Hemish-Patel/Sunrise-Alarm-Clock/CircuitBlueprint/PCB_Render.png

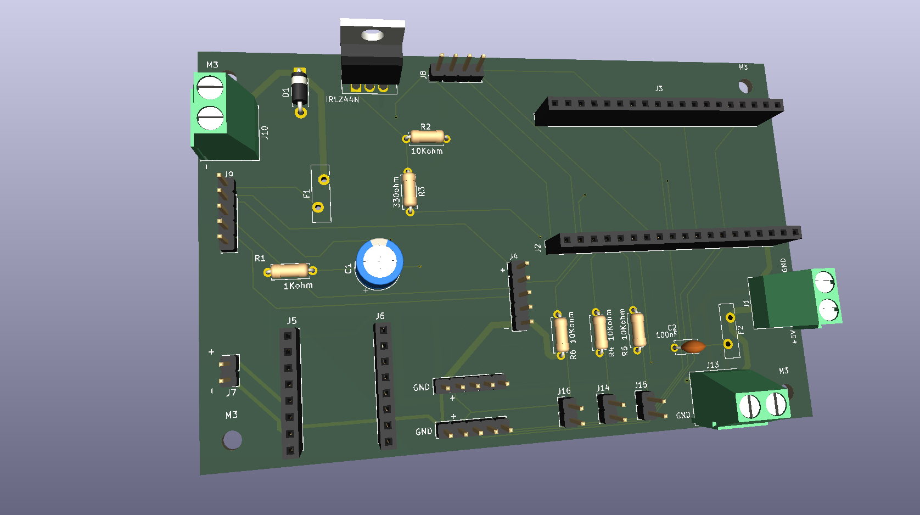
CircuitBlueprint/PCB_Render.png
