Hemish-Patel/Sunrise-Alarm-Clock/Docs/2_InitialDesign/INFO.txt

Sets out the hardware architectural decision, and initial circuitry
The components and parts that are needed to meet the system's requirements 
and how they fit together
