Hemish-Patel/Sunrise-Alarm-Clock/Docs/3_Schematics/INFO.txt

Sets out top level view of software flow
Main features, settings, and research on how to best implement the projects desired goals
