Hemish-Patel/Sunrise-Alarm-Clock/Docs/1_SystemRequirementsAndConstraints/1_SystemRequirementAndConstraints.docx

1. System Requirements & Constraints

1.1 Functional Requirements (FR)

What the system must physically do.

- FR-01 (Automated Lighting): The system SHALL execute a 45 minute dimming sequence, culminating at 100% brightness at a user-defined alarm time.
- FR-02 (Manual Override): The system SHALL provide an independent manual lighting mode, controlled via a dedicated physical rotary encoder, which overrides automated lighting schedules.
- FR-03 (Audio Output): The system SHALL output digitized audible alarms from local SD storage via a dedicated 3W speaker, triggered at specific points in build up to alarm time.
- FR-04 (Mechanical Output): The system SHALL actuate a physical twin-bell mechanical hammer mechanism at alarm time.
- FR-05 (Time Retention): The system SHALL maintain accurate real-time clock data during a total mains power loss, completely independent of network connectivity.
- FR-06 (Visual Output): The system SHALL provide continuous visual feedback of the current real-time clock data and system states (e.g., alarm armed/disarmed).

1.2 Non-Functional Requirements (NFR)

The quality standard to which the system must perform.

- NFR-01 (Acoustic Performance): The AC dimming circuit SHALL operate without inducing acoustic resonance (buzzing) in the LED load across the entire dimming range.
- NFR-02 (UX Handoff): The system software SHALL execute a "bumpless transfer" between automated alarm states and manual lighting states, preventing sudden voltage spikes or brightness jumps.
- NFR-03 (Tactile Operation): The primary alarm termination protocol SHALL be executable via a single, absolute-state hardware switch, requiring no navigation of the state machine.
- NFR-04 (Independent Alarm Features): The separate alarm features SHALL be independently activated and deactivated via absolute-state hardware switch, requiring no navigation of the state machine.
- NFR-05 (Domestic Aesthetic & Ambient Quality): The light emitter SHALL be aesthetically pleasing and deliver warm-spectrum, ensuring visual suitability as a decorative bedside light.

1.3 Design Constraints (C)

The absolute limits the design cannot cross.

- C-01 (Electrical Safety): The system MUST operate from a standard 230V 50Hz UK mains supply, enforcing strict protective electrical separation and hazardous-voltage isolation between the mains domain and all user-accessible low-voltage interfaces in compliance with relevant electrical safety standards.
- C-02 (Thermal Management): The system MUST maintain safe internal operating temperatures for the enclosure exclusively through passive ventilation, prohibiting the use of active cooling fans or high-thermal-loss resistive loads.
- C-03 (Budget): The total prototype Bill of Materials (BOM) MUST NOT exceed £100.00.
