Hemish-Patel/Sunrise-Alarm-Clock/Docs/2_InitialDesign/LogicalArchitecture.docx

| Option 1 | Option 2 | Option 3
Light Bulb Type | Cheap LED | Premium LED | Halogen
Dimmer Circuitry | Leading Edge TRIAC | Trailing Edge MOSFET

1. Lighting Architecture

1.1 Combinations:

- Combination A: Trailing Edge MOSFET + Cheap LED
  - Pros: Cool to the touch (great for 3D-printed enclosures), highly energy-efficient, zero buzzing because trailing-edge dimming is smooth for electronics.
  - Cons: Requires a complex/expensive module or a custom high-voltage MOSFET gate driver design.
  - Cost: High (~£24+ for dimming hardware).
- Combination B: Leading-Edge TRIAC + Halogen Bulb
  - Pros: Flawless dimming down to 1% (no "pop-on" dead zone), natural warm orange colour shifting, incredibly cheap hardware (£4 TRIAC module + £2 bulb).
  - Cons: Generates massive thermal heat (high risk of warping plastic enclosures), high energy draw (~42W–60W).
  - Cost: Low (~£6 total).
- Combination C: Leading-Edge TRIAC + Premium LED
  - Pros: Cool to the touch and energy-efficient (like an LED), uses the cheap £4 TRIAC module, and the premium bulb's internal active filtering absorbs the TRIAC spikes to eliminate buzzing while mimicking the halogen colour-shift.
  - Cons: Premium bulbs cost slightly more than generic ones (~£7–£9 per bulb).
  - Cost: Moderate (~£12 total).
- Combination D: Leading-Edge TRIAC + Cheap LED
  - Pros: Extremely low component cost, highly energy-efficient source lighting.
  - Cons: Severe acoustic resonance (loud electrical buzzing), poor dimming fidelity characterized by a wide "pop-on" dead zone and sudden drop-offs, and high risk of premature internal driver degradation due to unregulated phase-cut chopping spikes.
  - Cost: Very Low (~£7 total).

1.2 Evaluation:

( 5 Max (Good), 1 Min(Bad) )

Evaluation Criteria | Weight | Combination A (MOSFET + Cheap LED) | Combination B (TRIAC + Halogen) | Combination C (TRIAC + Premium LED) | Combination D (TRIAC + Cheap LED)
Acoustic Silence | 5 | 5 | 5 | 4 | 1
Thermal Safety | 5 | 5 | 1 | 5 | 5
Dimming Fidelity | 4 | 3 | 5 | 4 | 1
Energy Efficiency | 3 | 5 | 1 | 5 | 5
Implementation Cost | 3 | 2 | 5 | 4 | 5
Weighted Total Score | | 72 / 100 | 53 / 100 | 86 / 100 | 57 / 100

* Architectures combining a Trailing-Edge MOSFET with either a Halogen or Premium LED were excluded from the formal evaluation matrix. The higher-cost MOSFET topology is specifically implemented to mitigate the acoustic and dimming limitations of Standard LEDs. Pairing a MOSFET with emitters that already possess optimal dimming characteristics (Halogen) or internal active filtering (Premium LED) introduces redundant implementation costs with zero performance gain, immediately violating constraint C-03 (Budget).

1.3 Decision:

Winner: Combination C: Leading-Edge TRIAC + Premium LED

2. User Interface (UI) Architecture

2.1 Lighting & Menu Control (Rotary Encoder vs. Potentiometer)

To satisfy the manual lighting override (FR-02) and the "bumpless transfer" (NFR-02) requirements, an infinite-spin Rotary Encoder was selected over a traditional Analog Potentiometer.

- The State Desynchronization Flaw:
  - A potentiometer is an absolute input device. If the automated sunrise sequence brings the lamp to 100% brightness, but the physical potentiometer dial was left pointing at 10% from the previous night, touching the dial would instantly drop the brightness to 10%. This violent state mismatch violates NFR-02.
- The Encoder Solution:
  - A rotary encoder is a relative input device. It tracks positional changes (+1 or -1) rather than absolute position. This allows the ESP32 software to seamlessly sync the physical dial's input with the current software-driven brightness value, enabling a flawless, glitch-free handoff between automated and manual states.

2.2 Independent Alarm Feature Control (Toggle Switches vs. Push Buttons)

To satisfy the tactile operation requirement (NFR-03) and the independent alarm features requirement (NFR-04), three dedicated Hardware SPST Toggle Switches were selected as the arm/disarm interfaces for the light sunrise sequence, speaker noises, and metal bells, rather than utilizing the UI screen and push buttons.

- Modular Independence:
  - Providing dedicated hardware switches for the light sunrise sequence, speaker noises, and metal bells allows the user to physically customize their wake-up protocol (e.g., arming the sunrise light but disarming the mechanical bells) without needing to configure complex software settings.
- Bypassing the State Machine:
  - Utilizing physical toggle switches allows the user to immediately arrest specific lighting, digital audio, or mechanical alarm outputs via muscle memory without needing visual confirmation or UI navigation.
- Absolute State Confirmation:
  - The physical UP/DOWN position of each switch provides immediate tactile confirmation of exactly which individual alarm features are armed for the next morning, eliminating the anxiety associated with hidden software-only toggle states.

2.3 Visual Output (Integrated-Driver 7-Segment LED vs. Backlit LCD)

To satisfy the visual output requirement (FR-06), four display architectures were evaluated:

- Option A: Raw Multiplexed 7-Segment LED: Rejected.
  - Requires continuously multiplexing up to 12 GPIO pins, resulting in extremely poor pin economy that would consume an unacceptable percentage of the microcontroller's I/O budget.
- Option B: Backlit LCD Screen: Rejected.
  - Requires a continuous backlight that illuminates the entire rectangular footprint of the display, causing unwanted ambient light pollution in a dark room.
- Option C: OLED Module: Rejected.
  - While visually impressive, an OLED is functional overkill for displaying basic numerical digits and significantly increases component cost. Furthermore, organic pixels suffer from permanent burn-in when displaying static time data 24/7.
- Option D: Integrated-Driver 4-Digit 7-Segment LED (Selected):
  - Handles multiplexing locally via an integrated IC, offering excellent pin economy (requiring only a 2-wire serial interface). It emits light strictly from the active numerals and allows for software-defined brightness stepping, enabling a cost-effective, sleep-friendly nighttime mode.

3. Audio & Mechanical Alarm Architecture

3.1 Digital Audio Generation (Hardware Decoder vs. Microcontroller DAC)

To satisfy the digital audio output requirement (FR-03), three audio generation architectures were evaluated:

- Option A: Microcontroller DAC / Software PWM: Rejected.
  - Generating audio directly from the MCU consumes critical hardware timers required by the TRIAC zero-cross detection. This risks fatal system instability and lighting flicker.
- Option B: External I2S DAC Amplifier: Rejected.
  - While providing high fidelity, this is functional overkill for basic alarm noises. It increases component cost and still requires the main microcontroller to read massive audio files from storage and push them over the I2S bus, creating unacceptable CPU memory overhead.
- Option C: Dedicated Hardware MP3 Decoder (Selected):
  - An industry-standard approach for embedded audio. It provides independent local SD storage and internal decoding, requiring only low-bandwidth asynchronous serial commands from the MCU. This keeps costs low while entirely freeing system resources for the lighting dimmer.

3.2 Mechanical Bell Actuation (Solid-State MOSFET vs. Mechanical Relay)

To drive the DC motor of the salvaged mechanical twin-bell hammer mechanism (FR-04), three switching architectures were evaluated:

- Option A: Electromechanical Relay: Rejected.
  - Physical contacts degrade over time due to inductive arcing from DC motors, and a relay cannot scale the 5V supply voltage down via PWM to protect the 1.5V analog bell motor.
- Option B: Dedicated H-Bridge Motor Driver IC: Rejected.
  - H-Bridges are designed for bi-directional motor control (forward and reverse). Because the bell hammer only requires unidirectional actuation, using a dedicated IC is functional overkill that needlessly inflates both the BOM cost and the PCB footprint.
- Option C: Logic-Level N-Channel MOSFET (Selected):
  - The industry standard for unidirectional DC load switching. It is highly cost-effective, provides solid-state reliability with infinite mechanical lifespan, and allows for high-frequency PWM voltage scaling to safely drive the 1.5V motor from the 5V rail.

3.3 Time Keeping Retention (Internal Counter vs. Network Time vs. Dedicated Hardware RTC)

To satisfy the time retention requirement (FR-05), three timekeeping architectures were evaluated:

- Option A: Network Time Protocol (NTP) via Wi-Fi: Rejected.
  - Relies on external wireless network connectivity, directly violating the requirement to operate completely independent of network connectivity during power loss or offline scenarios (FR-05).
- Option B: Microcontroller Internal RTC / Software Counter: Rejected.
  - While independent of external networks, an internal software timer or software-managed RTC loses all time data instantly upon a total mains power cut or unplugging, completely failing to provide the required power-loss time retention (FR-05).
- Option C: Dedicated Hardware RTC Module with Battery Backup (Selected):
  - An industry-standard approach for robust embedded timekeeping. It utilizes an independent integrated circuit with a dedicated coin-cell battery backup to maintain precise time data during total mains power loss, operating completely independent of network connectivity while consuming zero main CPU overhead.

4. Power & Isolation Architecture

4.1 Low-Voltage Power Supply

To satisfy the strict electrical safety constraints (C-01) and thermal management constraints (C-02), three primary AC-to-DC step-down architectures were evaluated to power the 5V logic domain from the 230V mains supply.

- Option A: Transformerless Capacitive Dropper: Rejected.
  - While highly cost-effective and compact, this architecture provides zero galvanic isolation. A failure would expose the 5V logic circuit—and all user-accessible metal toggle switches—to lethal mains voltage, violently failing C-01.
- Option B: Linear Power Supply (Step-Down Transformer + Bridge Rectifier + LDO): Rejected.
  - This traditional architecture provides excellent galvanic isolation (safety) and clean DC output. However, linear regulators drop excess voltage strictly by dissipating it as heat. This thermal dissipation violates the passive cooling limits of a sealed plastic enclosure (C-02).
- Option C: Galvanically Isolated Switch-Mode Power Supply (SMPS) (Selected):
  - An SMPS utilizes a high-frequency transformer, physically separating the high-voltage and low-voltage domains to guarantee user safety. Unlike linear supplies, switch-mode topology operates at high efficiency with minimal thermal loss, successfully satisfying both the electrical safety and passive ventilation requirements.

5. Compute & Microcontroller Architecture

5.1 System I/O and Peripheral Budget

Before selecting a central processor, the total interface load of the selected sub-systems must be quantified to ensure the chosen microcontroller possesses adequate hardware resources.

Required GPIO & Bus Interfaces:

- Lighting (TRIAC): 1x Interrupt pin (Zero-cross detection), 1x High-precision hardware timer/PWM pin (Phase-cut firing).
- Timekeeping (RTC): 2x pins (Hardware I2C: SDA, SCL).
- User Interface (Inputs): 4x Interrupt-capable pins (2x Rotary Encoder DT/CLK), 5x Standard Digital Inputs (2x Encoder SW, 3x Toggle Switches), 2x Standard Digital Inputs (Tactile Push Buttons).
- Visual Output (Display): 2x Digital pins (Serial CLK, DIO).
- Audio (MP3 Decoder): 2x pins (Hardware UART: TX, RX).
- Actuator (Bell MOSFET): 1x PWM pin.

Total Budget: Minimum 20 GPIO pins, including at least 5 hardware interrupt pins, hardware I2C, hardware UART, and independent hardware timers.

*Microcontroller Selection will be based around these requirements which will be confirmed in next phase after their confirmation when specific hardware has been selected.
