Hemish-Patel/Sunrise-Alarm-Clock/Docs/2_InitialDesign/PhysicalArchietecture.docx

1. Lighting Architecture

- Premium LED: Philips Master DimTone 2200K – 2700K E27 Clear Filament Lamp (10.5W).
- Dimmer Circuitry: RobotDyn 4A DM-AC-1CH-4A TRIAC Dimmer.

Requirement Integration: Paired together, the internal active filtering of the premium LED completely eliminates acoustic resonance from the TRIAC phase-cutting, successfully satisfying NFR-01 (pending physical prototype validation). Furthermore, the bulb's clear-filament aesthetic and warm colour-shifting profile at low brightness satisfy the domestic bedside integration required by NFR-05. Finally, this dimmable hardware combination provides the physical actuation necessary to execute the core 45-minute sunrise sequence defined in FR-01. TRIAC Dimmer’s optical isolation also ensures galvanic separation between 230V and the Low-Voltage parts of the system satisfying CR-01.

2.User Interface Architecture

- Rotary Encoders: KY-040 Rotary Encoders
- Toggle Switches: MTS 101 Mini Toggle Switches
- Integrated-Driver 4-Digit 7-Segment Display: TM1637 4 Digit 7-Segment Display Red

Requirement Integration: The KY-040 rotary encoders provide relative positional input to satisfy manual lighting overrides (FR-02) and execute a "bumpless transfer" (NFR-02). The MTS-101 toggle switches provide absolute-state physical control for independent feature arming/disarming (NFR-04), enabling immediate tactile operation without state machine navigation (NFR-03). The TM1637 display delivers continuous, low-pollution visual feedback of real-time clock and system states (FR-06) while minimising the microcontroller's GPIO pins.

3. Audio & Mechanical Alarm Architecture

- Dedicated Hardware MP3 Decoder: Mini-YX5200 Dfplayer
- Mechanical Bell Actuation N-Type MOSFET: IRLZ44N
- Time Keeping Real Time Clock Module: Mini DS3231 RTC module

Requirement Integration: The DFPlayer enables audible alarms from local storage (FR-03) without taxing microcontroller timing loops. The DS3231 maintains accurate real-time clock data during total mains power loss (FR-05). The MOSFET provides solid-state reliability and PWM voltage scaling to actuate the physical twin-bell hammer mechanism at alarm time (FR-04).

4. Power and Isolation Architecture

- Low Voltage Power Supply Galvanically Isolated SMPS: Mean Well IRM-30-5ST 30W

Requirement Integration: The Mean Well SMPS provides strict galvanic separation between the 230V mains and 5V logic domains while maintaining high efficiency and minimal thermal loss, satisfying electrical safety (C-01) and passive thermal management (C-02) constraints.

5. Computer and Microcontroller Architecture

- Microcontroller: ESP32-WROOM-32D (38-Pin DevKitC Core Board)

Requirement Integration: The ESP32 provides a sufficient GPIO budget for the following minimum GPIO pins needed:

- Lighting (TRIAC): 1x Interrupt pin (Zero-cross detection), 1x High-precision hardware timer/PWM pin (Phase-cut firing).
- Timekeeping (RTC): 2x pins (Hardware I2C: SDA, SCL).
- User Interface (Inputs): 4x Interrupt-capable pins (2x Rotary Encoder DT/CLK), 5x Standard Digital Inputs (2x Encoder SW, 3x Toggle Switches), 2x Standard Digital Inputs (Tactile Push Buttons).
- Visual Output (Display): 2x Digital pins (Serial CLK, DIO).
- Audio (MP3 Decoder): 2x pins (Hardware UART: TX, RX).
- Actuator (Bell MOSFET): 1x PWM pin.
- Total Budget: Minimum 20 GPIO pins, including at least 5 hardware interrupt pins, hardware I2C, hardware UART, and independent hardware timers.

The dual-core and hardware resources can enable isolation of high-priority TRIAC zero-cross interrupts on Core 0 from user interface and audio tasks running on Core 1. Plus, enough compute, WiFi and Bluetooth for additional features and future improvements.
