Hemish-Patel/Sunrise-Alarm-Clock/Docs/3_Schematics/Sunrise Clock Master Pinout Map.xlsx

ESP32 Sunrise Clock Pinout Map
Component | Pin Function | ESP32 GPIO | I/O Direction | Wiring Notes
DS3231 RTC | SDA | GPIO 21 | In/Out | I2C Data. Pull-ups built into module.
DS3231 RTC | SCL | GPIO 22 | Output | I2C Clock.
DFPlayer Mini | RX | GPIO 17 (TX2) | Output | MUST use 1k ohm series resistor.
DFPlayer Mini | TX | GPIO 16 (RX2) | Input | Direct connection safe (3.3V logic).
TRIAC Dimmer | Zero-Cross (Z-C) | GPIO 36 (VP) | Input | Input-only pin. Needs hardware interrupt. No internal pull up or pull down resistors
TRIAC Dimmer | PWM / Gate | GPIO 26 | Output | Drives the optoisolator.
Bell Motor (MOSFET) | Gate Drive | GPIO 27 | Output | Needs 330 ohm series + 10k ohm pull-down.
TM1637 Display | CLK | GPIO 18 | Output | Standard digital out.
TM1637 Display | DIO | GPIO 19 | In/Out | Standard digital in/out.
Toggle Switch 1 | Arm/Disarm | GPIO 34 | Input | Input-only. Relies on external 10k ohm pull-down.
Toggle Switch 2 | Mode Override | GPIO 35 | Input | Input-only. Relies on external 10k ohm pull-down.
Toggle Switch 3 | Network Swap | GPIO 39 (VN) | Input | Input-only. Relies on external 10k ohm pull-down.
Rotary Enc 1 (Time) | CLK | GPIO 25 | Input | Hardware interrupt recommended.
Rotary Enc 1 (Time) | DT | GPIO 32 | Input | Hardware interrupt recommended.
Rotary Enc 1 (Time) | SW (Button) | GPIO 33 | Input | Needs pull-up (internal or via KY-040).
Rotary Enc 2 (Menu) | CLK | GPIO 4 | Input | Hardware interrupt recommended.
Rotary Enc 2 (Menu) | DT | GPIO 13 | Input | Hardware interrupt recommended.
Rotary Enc 2 (Menu) | SW (Button) | GPIO 23 | Input | Needs pull-up (internal or via KY-040).
