Hemish-Patel/Sunrise-Alarm-Clock/CircuitBlueprint/PCB_Blank_Render.png

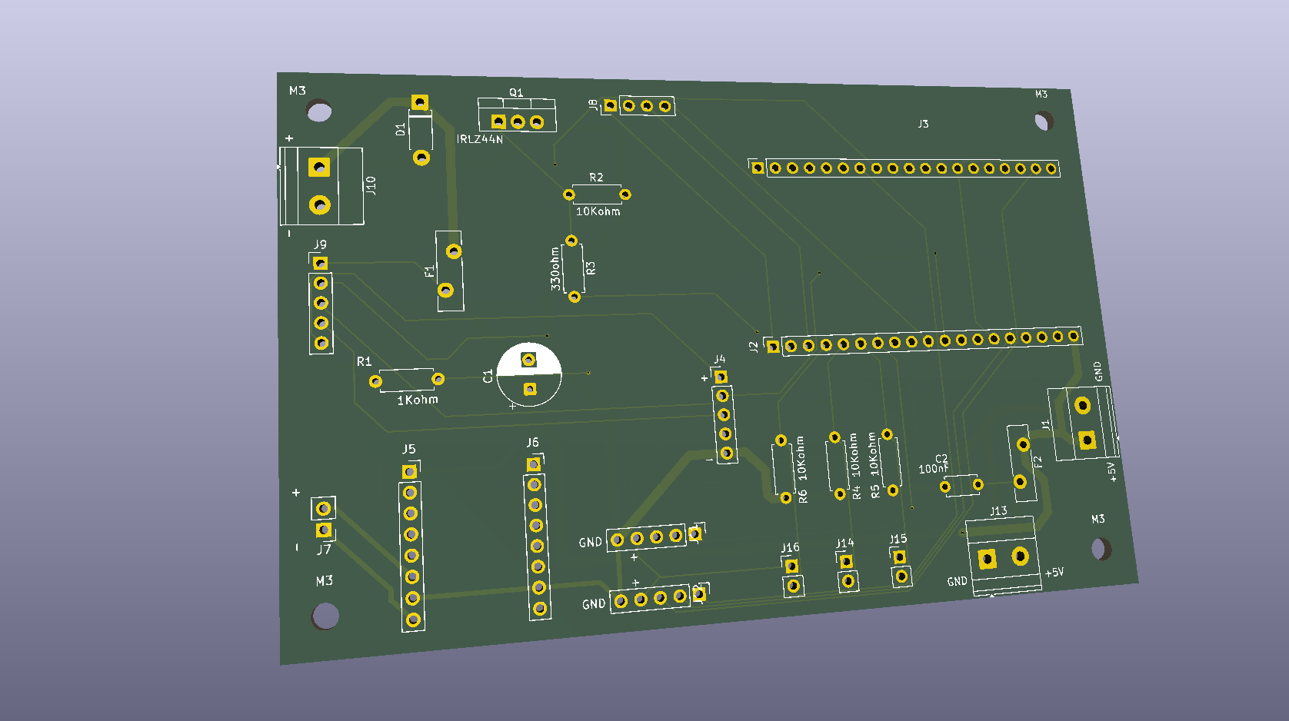
CircuitBlueprint/PCB_Blank_Render.png
