Hemish-Patel/Sunrise-Alarm-Clock/CircuitBlueprint/PCB_Layout.PNG

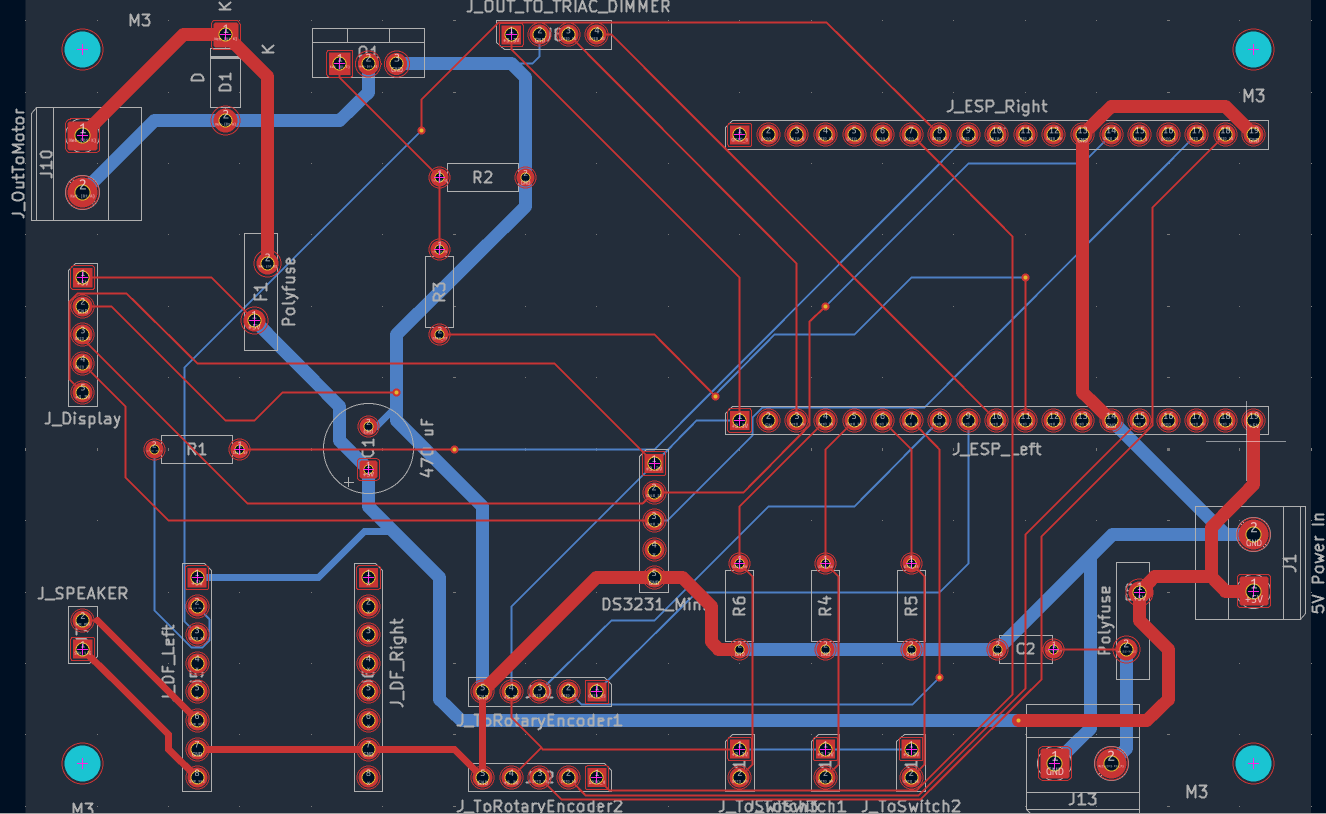
CircuitBlueprint/PCB_Layout.PNG
