Hemish-Patel/Sunrise-Alarm-Clock/Docs/3_Schematics/BreadBoardDesign_bb.png

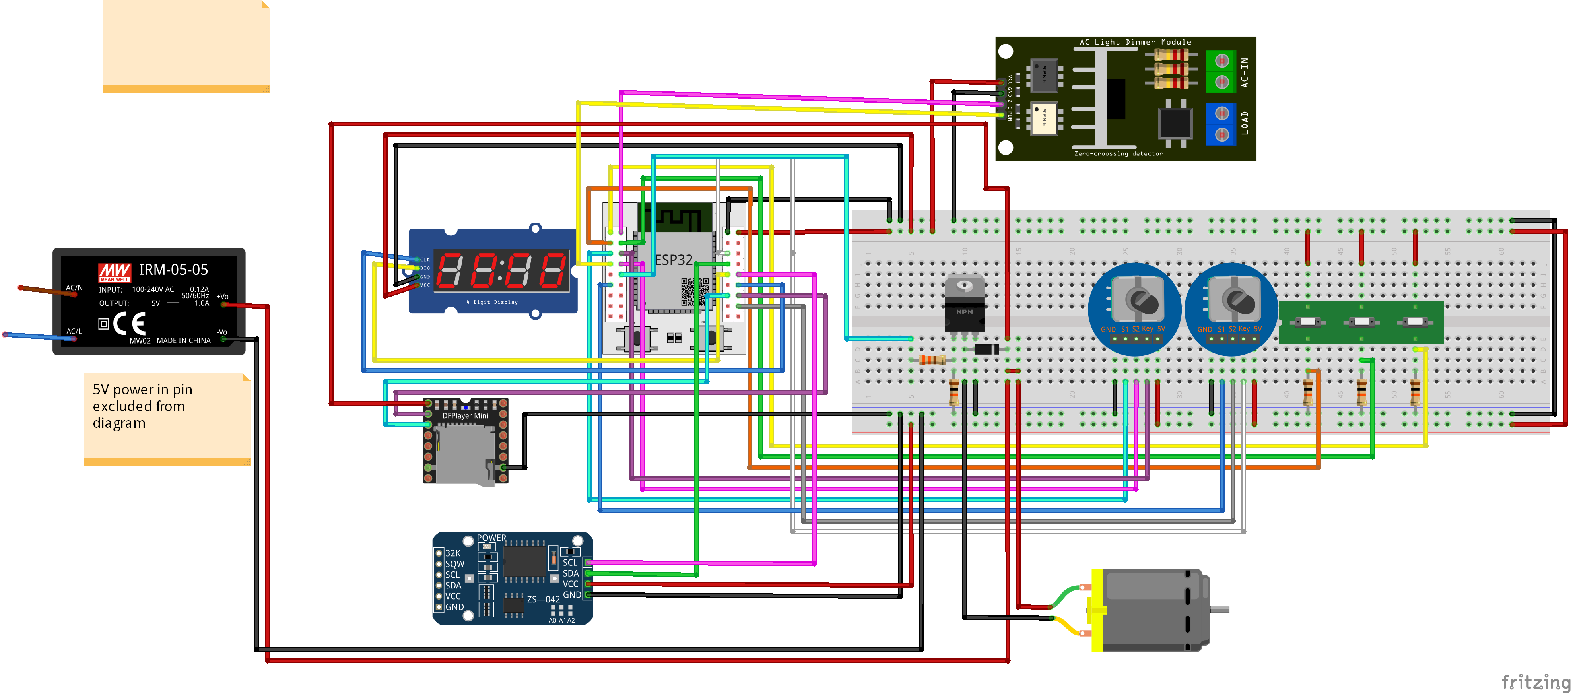
Docs/3_Schematics/BreadBoardDesign_bb.png
