Hemish-Patel/Sunrise-Alarm-Clock/Docs/ProjectFinances_Costs.xlsx

Component | Component Name | Quantity Bought | Quantity Needed | Cost | Cost per Unit | Cost for Completed Product
Buttons | Tactile Push Buttons | 250 |  | £3.82 | £0.02
Speaker | Speaker 3W 8Ohm | 1 |  | £2.10 | £2.10
Resistors | Assorted Resistors | 300 |  | £1.51 | £0.01
MicroController | ESP32-WROOM-32D Dev Kit | 1 |  | £4.09 | £4.09
N-Type MOSFET | IRLZ44N | 10 |  | £2.61 | £0.26
Audio Module | Mini-YX5200 Dfplayer | 1 |  | £1.52 | £1.52
DPST Switch | Honyone MR-6B Rocker Switch | 5 |  | £2.91 | £0.58
AC Light Dimming Module | RobotDyn 4A DM-AC-1CH-4A | 1 |  | £3.94 | £3.94
Breadboard + jumper cables | Breadboard + jumper cables | 1 |  | £4.24 | £4.24
Switches | MTS 101 Mini Toggle Switches | 5 |  | £3.21 | £0.64
Mains Conductor Splitter | Wago 221-413 | 12 |  | £5.26 | £0.44
SD Card | RaspberryPI 16GB MicroSD Card | 1 |  | £8.99 | £8.99
Mains Plug | 3 Pin 1.5m Uk Mains Plug | 1 |  | £5.75 | £5.75
Premium Light Bulb | Phillips 10.5W GlowWarm Clear Filament Dimmable Bulb | 1 |  | £8.25 | £8.25
Display | TM1637 4 Digit 7-Segment Display Red | 1 |  | £1.18 | £1.18
Rotary Encoders | KY-040 Rotary Encoders | 5 |  | £4.63 | £0.93
Real Time Clock Module | Mini DS3231 RTC module | 1 |  | £2.46 | £2.46
Alarm Bells | 4" Twin Bells Alarm Clock (For Harvest) | 1 |  | £7.03 | £7.03
5V Power Supply | Mean Well IRM-30-5S, 30W | 1 |  | £15.59 | £15.59
wireless charger pcb | Qi2/MagSafe Magnetic 15W High-Power Wireless Charger | 1 |  | £2.49 | £2.49
wireless charger allingment magnets | 16-Pc Mag Tx | 1 |  | £1.21 | £1.21
Full Size Display | Adafruit 1.2" 4-Digit 7-Segment Display w/I2C Backpack - Red | 1 |  | £20.60 | £20.60
 |  |  |  | £113.39
