Hemish-Patel/Sunrise-Alarm-Clock/CircuitBlueprint/CircuitBlueprint.step

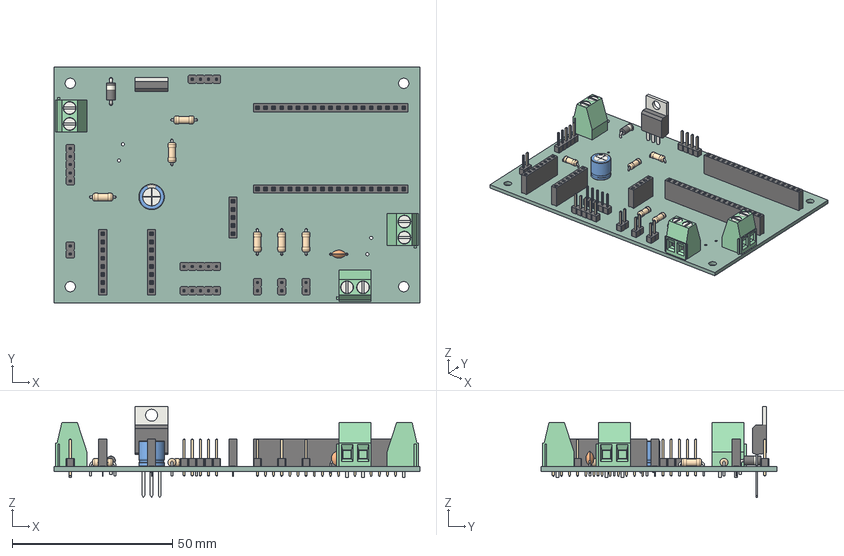
[picture p5: CAD file, 2026-09-24]
CircuitBlueprint/CircuitBlueprint.step
114.3 x 73.7 x 28.5 mm
PinHeader_1x02_P254mm_Vertical x 4
PinHeader_1x05_P254mm_Vertical x 3
PinSocket_1x08_P2.54mm_Vertical x 2
R_Axial_DIN0207_L63mm_D25mm_P762mm_Horizontal x 6
PinSocket_1x05_P2.54mm_Vertical
PinSocket_1x19_P2.54mm_Vertical x 2
CP_Radial_D80mm_P380mm
TerminalBlock_Phoenix_MKDS-1,5-2_1x02_P5.00mm_Horizontal x 3
D_DO-41_SOD81_P7.62mm_Horizontal
TO-220-3_Vertical
PinHeader_1x04_P254mm_Vertical
C_Disc_D47mm_W25mm_P500mm
Cir3387_PCB
