Hemish-Patel/Sunrise-Alarm-Clock/(list of files, drawings)

Other design files:
Docs/3_Schematics/BreadBoardDesign.fzz
