Hemish-Patel/Sunrise-Alarm-Clock/CircuitBlueprint/CircuitBlueprint.kicad_pcb

## KiCad design CircuitBlueprint/CircuitBlueprint.kicad_pcb (2026-10-10)

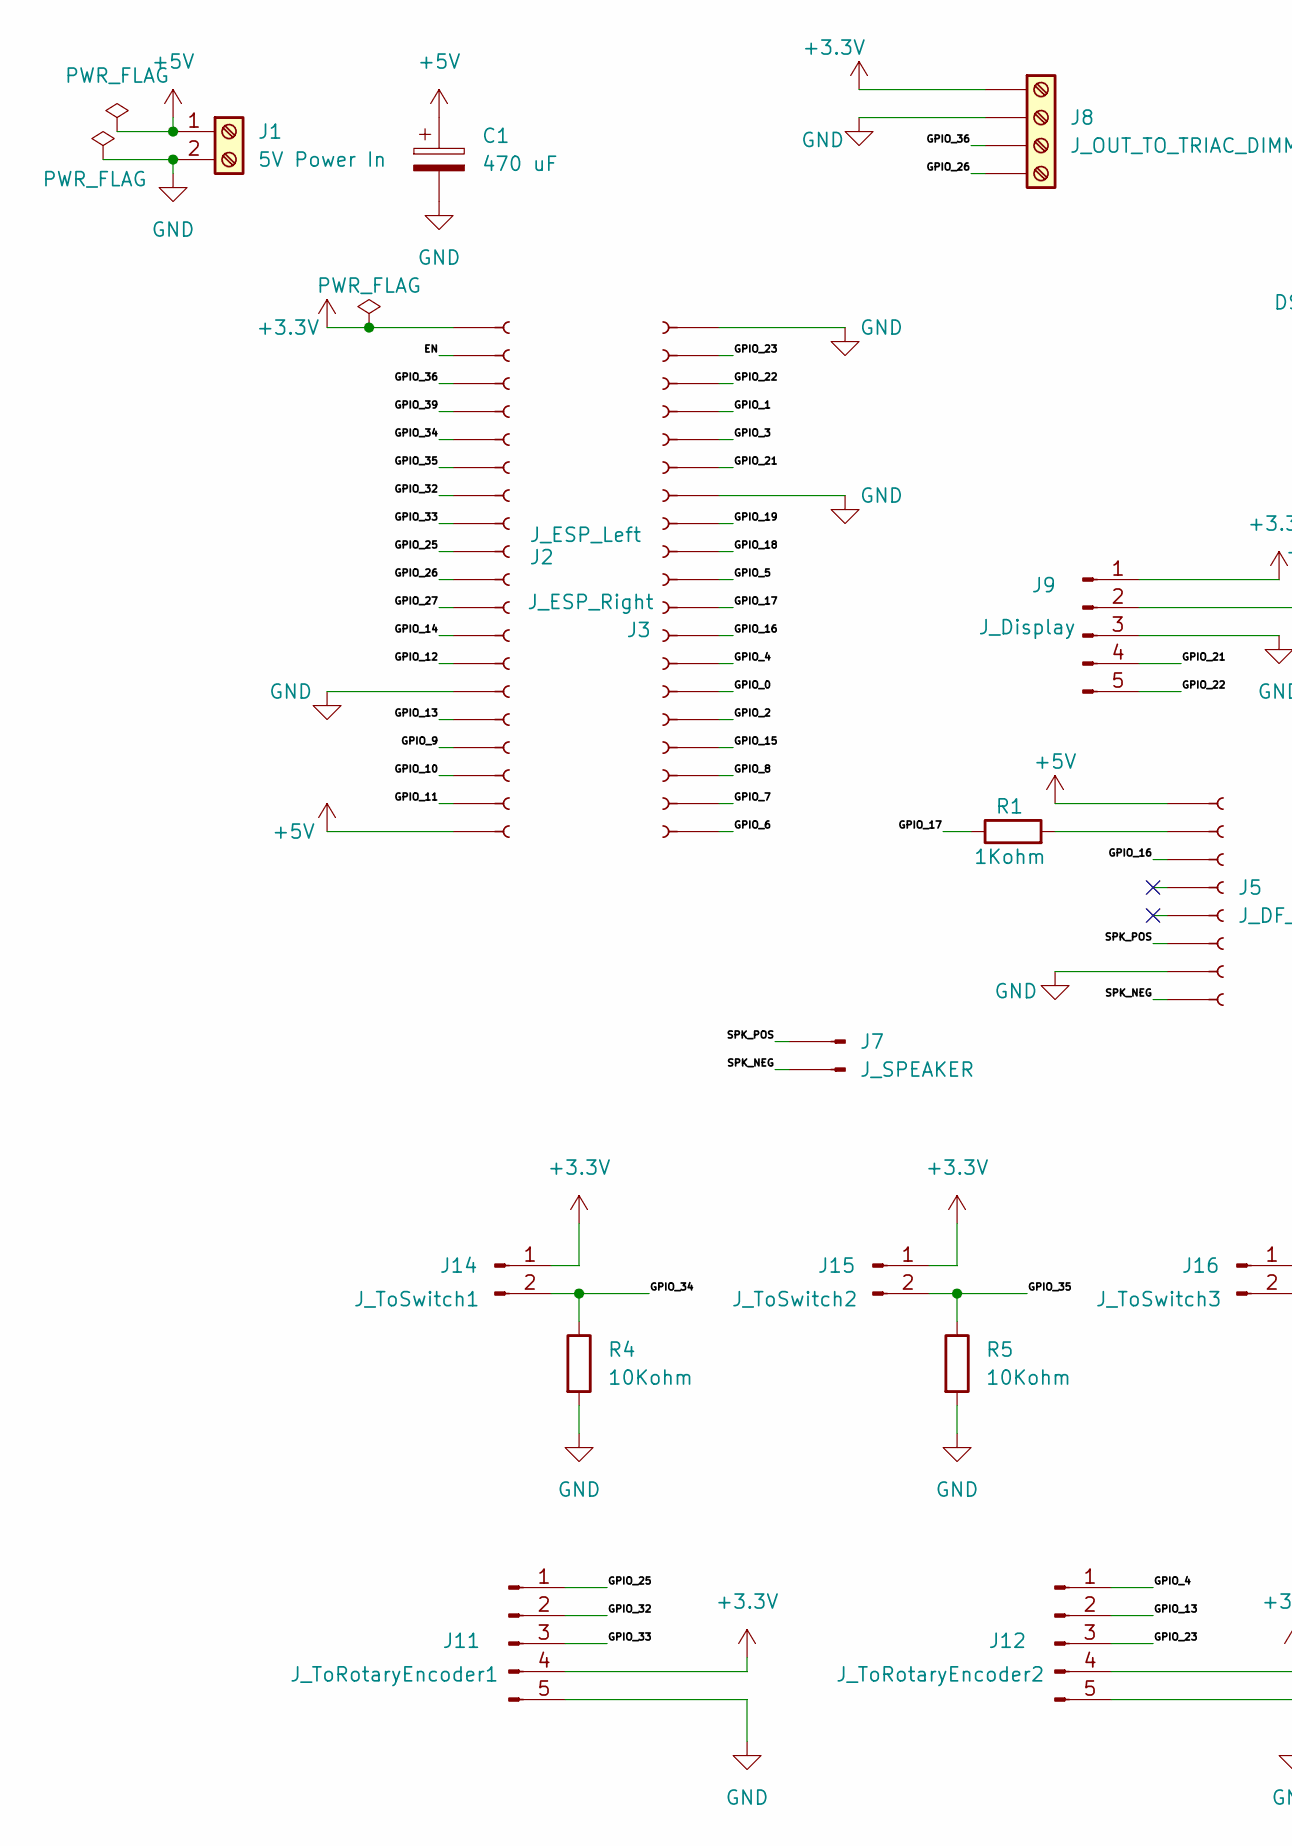
[picture p7: schematic CircuitBlueprint.kicad_sch, part in row 1, column 1]

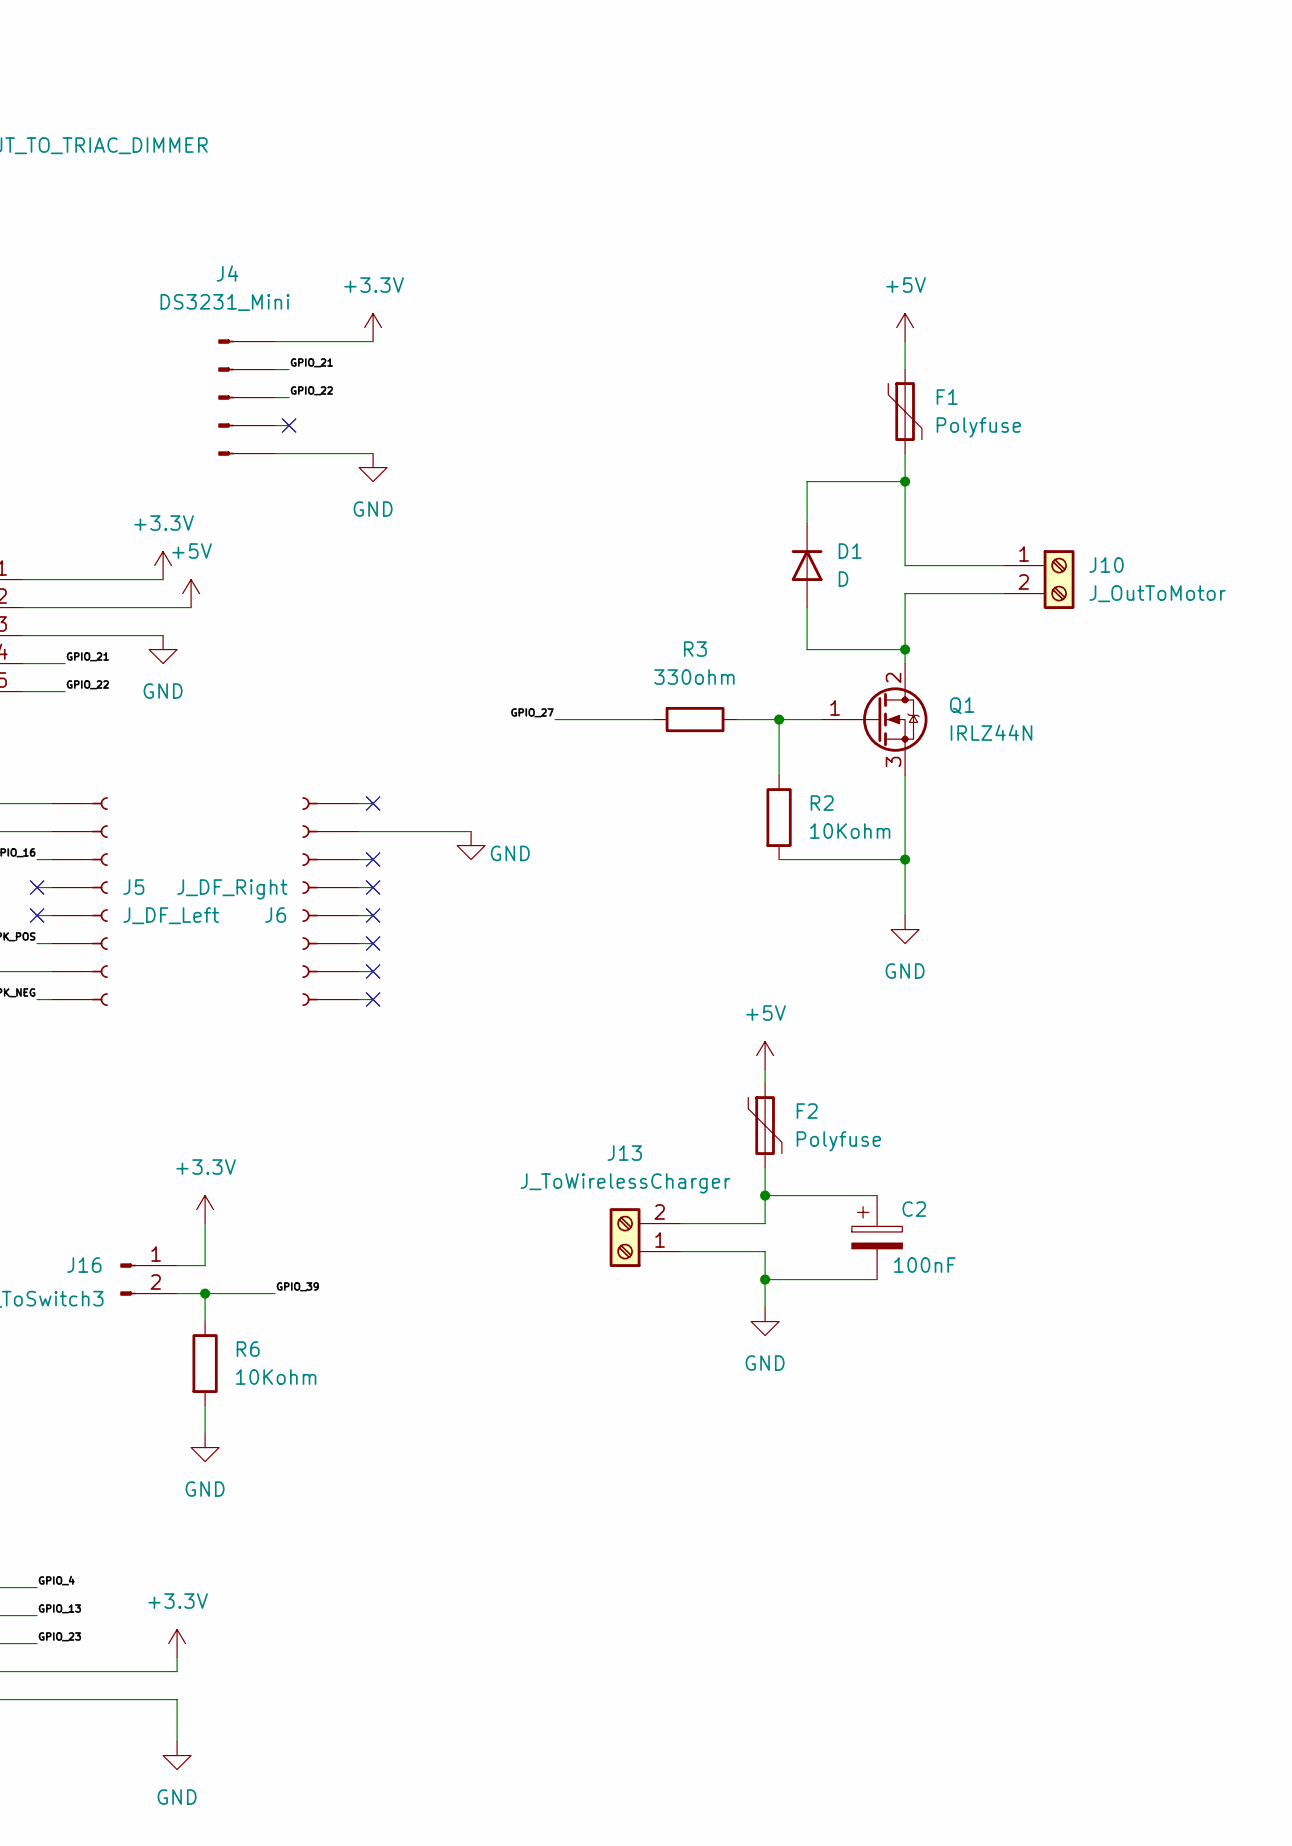
[picture p8: schematic CircuitBlueprint.kicad_sch, part in row 1, column 2]

Parts:
C1: 470 uF; CP_Radial_D8.0mm_P3.80mm
C2: 100nF; C_Disc_D4.7mm_W2.5mm_P5.00mm
D1: D; D_DO-41_SOD81_P7.62mm_Horizontal
F1, F2: Polyfuse; Fuse_Bourns_MF-RG500
J1: 5V Power In; TerminalBlock_Phoenix_MKDS-1,5-2_1x02_P5.00mm_Horizontal
J2: J_ESP_Left; PinSocket_1x19_P2.54mm_Vertical
J3: J_ESP_Right; PinSocket_1x19_P2.54mm_Vertical
J4: DS3231_Mini; PinHeader_1x05_P2.54mm_Vertical
J5: J_DF_Left; PinSocket_1x08_P2.54mm_Vertical
J6: J_DF_Right; PinSocket_1x08_P2.54mm_Vertical
J7: J_SPEAKER; PinHeader_1x02_P2.54mm_Vertical
J8: J_OUT_TO_TRIAC_DIMMER; PinHeader_1x04_P2.54mm_Vertical
J9: J_Display; PinHeader_1x05_P2.54mm_Vertical
J10: J_OutToMotor; TerminalBlock_Phoenix_MKDS-1,5-2_1x02_P5.00mm_Horizontal
J11: J_ToRotaryEncoder1; PinHeader_1x05_P2.54mm_Vertical
J12: J_ToRotaryEncoder2; PinHeader_1x05_P2.54mm_Vertical
J13: J_ToWirelessCharger; TerminalBlock_Phoenix_MKDS-1,5-2_1x02_P5.00mm_Horizontal
J14: J_ToSwitch1; PinHeader_1x02_P2.54mm_Vertical
J15: J_ToSwitch2; PinHeader_1x02_P2.54mm_Vertical
J16: J_ToSwitch3; PinHeader_1x02_P2.54mm_Vertical
Q1: IRLZ44N; TO-220-3_Vertical
R1: 1Kohm; R_Axial_DIN0207_L6.3mm_D2.5mm_P7.62mm_Horizontal
R2, R4, R5, R6: 10Kohm; R_Axial_DIN0207_L6.3mm_D2.5mm_P7.62mm_Horizontal
R3: 330ohm; R_Axial_DIN0207_L6.3mm_D2.5mm_P7.62mm_Horizontal

Connections:
+3.3V: J2.1, J4.1, J8.1, J9.1, J11.4, J12.4, J14.1, J15.1, J16.1
+5V: C1.1, F1.1, F2.1, J1.1, J2.19, J5.1, J9.2
/EN: J2.2
/GPIO_0: J3.6
/GPIO_1: J3.16
/GPIO_2: J3.5
/GPIO_3: J3.15
/GPIO_4: J3.7, J12.1
/GPIO_5: J3.10
/GPIO_6: J3.1
/GPIO_7: J3.2
/GPIO_8: J3.3
/GPIO_9: J2.16
/GPIO_10: J2.17
/GPIO_11: J2.18
/GPIO_12: J2.13
/GPIO_13: J2.15, J12.2
/GPIO_14: J2.12
/GPIO_15: J3.4
/GPIO_16: J3.8, J5.3
/GPIO_17: J3.9, R1.1
/GPIO_18: J3.11
/GPIO_19: J3.12
/GPIO_21: J3.14, J4.2, J9.4
/GPIO_22: J3.17, J4.3, J9.5
/GPIO_23: J3.18, J12.3
/GPIO_25: J2.9, J11.1
/GPIO_26: J2.10, J8.4
/GPIO_27: J2.11, R3.2
/GPIO_32: J2.7, J11.2
/GPIO_33: J2.8, J11.3
/GPIO_34: J2.5, J14.2, R4.1
/GPIO_35: J2.6, J15.2, R5.1
/GPIO_36: J2.3, J8.3
/GPIO_39: J2.4, J16.2, R6.1
/SPK_NEG: J5.8, J7.1
/SPK_POS: J5.6, J7.2
GND: C1.2, C2.2, J1.2, J2.14, J3.13, J3.19, J4.5, J5.7, J6.7 (Pin_7_7), J8.2, J9.3, J11.5, J12.5, J13.1, Q1.3 (S), R2.2, R4.2, R5.2, R6.2
unnamed: D1.2 (A), J10.2, Q1.2 (D)
unnamed: D1.1 (K), F1.2, J10.1
unnamed: J5.2, R1.2
unnamed: C2.1, F2.2, J13.2
unnamed: Q1.1 (G), R2.1, R3.1

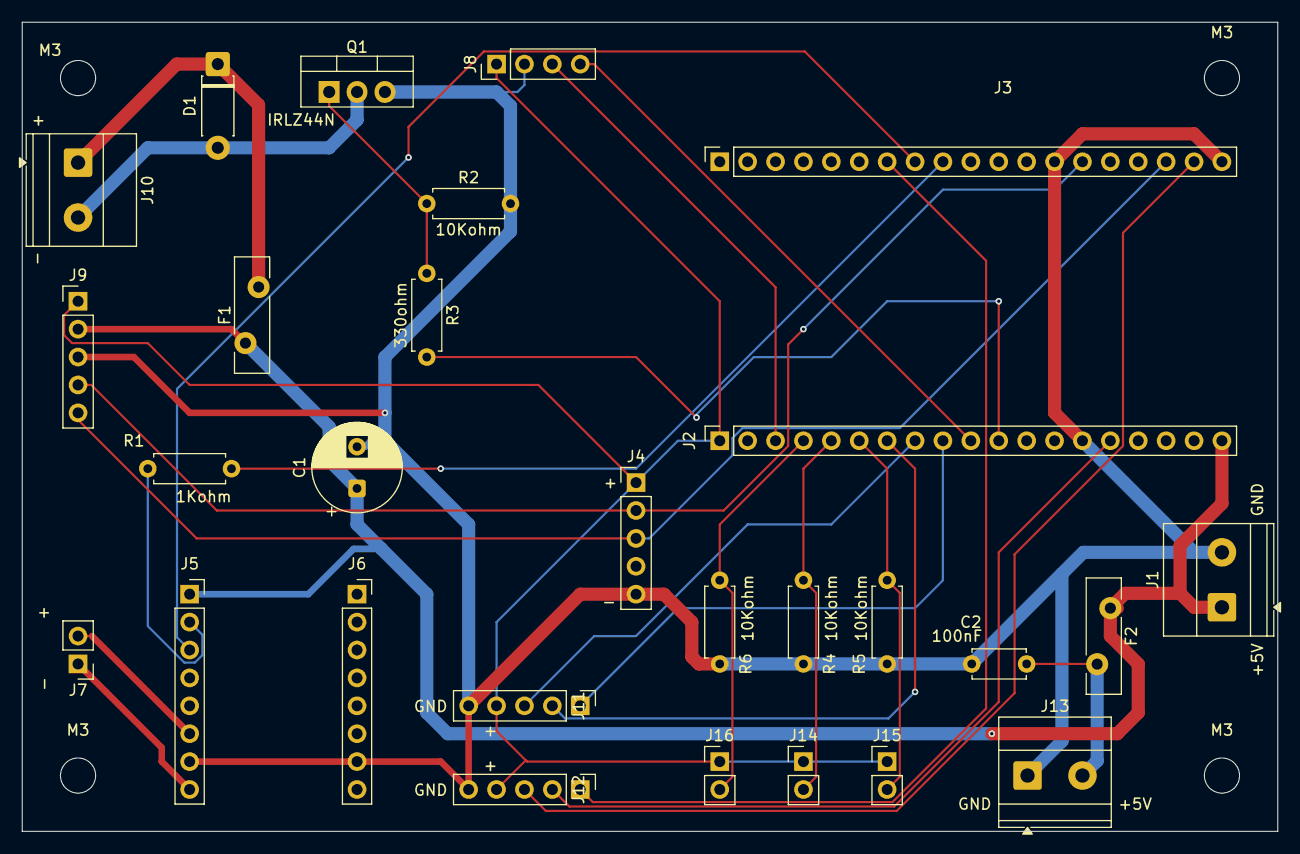
[picture p9: board CircuitBlueprint.kicad_pcb from above]

Board: 2 copper layers, 114.3 x 73.7 mm, 32 parts (0 on the bottom side), 26 nets.

Other parts of the board:
M3, M3#2, M3#3, M3#4: M3; MountingHole_3.2mm_M3
