Hemish-Patel/Sunrise-Alarm-Clock/(commit log)

2026-09-21 Initial commit: PlatformIO setup and blinking LED
2026-09-21 Linking Documentation
    [555TouchSwitch.fzz, 7Segment_direct.fzz, Amplification.fzz, AnalogInputFSR.fzz, AnalogInputOutput.fzz, AnalogInputPot.fzz, AnalogInputThermistor.fzz, AnalogInputToServo.fzz]
2026-09-21 Deleted the Fritzing app files and started the creation of class diagram
    [555TouchSwitch.fzz, 7Segment_direct.fzz, Amplification.fzz, AnalogInputFSR.fzz, AnalogInputOutput.fzz, AnalogInputPot.fzz, AnalogInputThermistor.fzz, AnalogInputToServo.fzz]
2026-09-24 Complete the KiCad schematic and PCB layout, also updated documentation
    [CircuitBlueprint.kicad_pcb, CircuitBlueprint.kicad_sch, CircuitBlueprint.step, ProjectFinances_Costs.xlsx]
2026-09-24 PCB updated trace thicknesses,rotary encoders and RTC can now talk to ESP
    [CircuitBlueprint.kicad_pcb]
2026-09-27 PCB trace thickness slightly modified, Bell motor contorl using mosfet and pwm added to gpio pin 27 - controlling led brightness to test, with the rotary encoder contorlling brightness and on/off
    [CircuitBlueprint.kicad_pcb]
2026-10-06 feat: add DisplayManager and 3x toggle switch sensing, the 7 seg display HT16K33 via I2C, minor main.cpp changes to test the features are working properly - display brightness with the rotary encoder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
    [CircuitBlueprint.kicad_pcb, CircuitBlueprint.kicad_sch]
2026-10-10 - Removed legacy hardware testing code from main loop - Built 3-phase wake-up timeline engine (Light ramp -> Audio ramp -> Bell cadence) - Added single-equation mathematical curves in AlarmManager fo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
    [CircuitBlueprint.kicad_pcb]
